tlambertz/rf_gas_meter/example_data/20221119_magnetometer_fine_1h.png

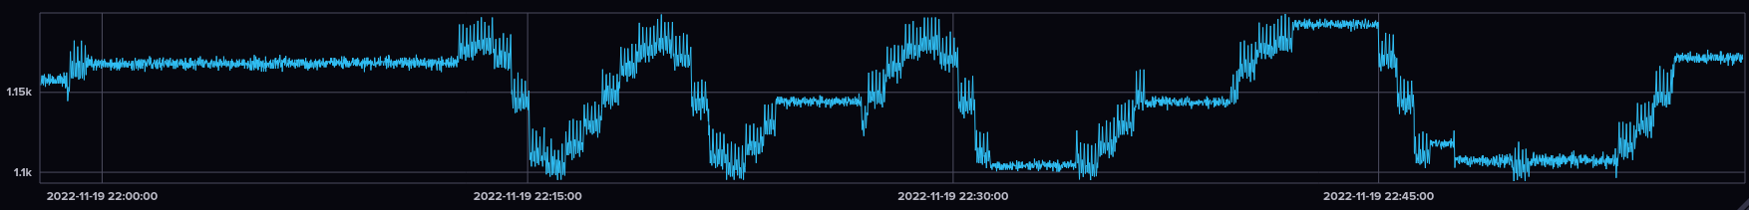
example_data/20221119_magnetometer_fine_1h.png
