tlambertz/rf_gas_meter/example_data/20221119_magnetometer_fine_3h.png

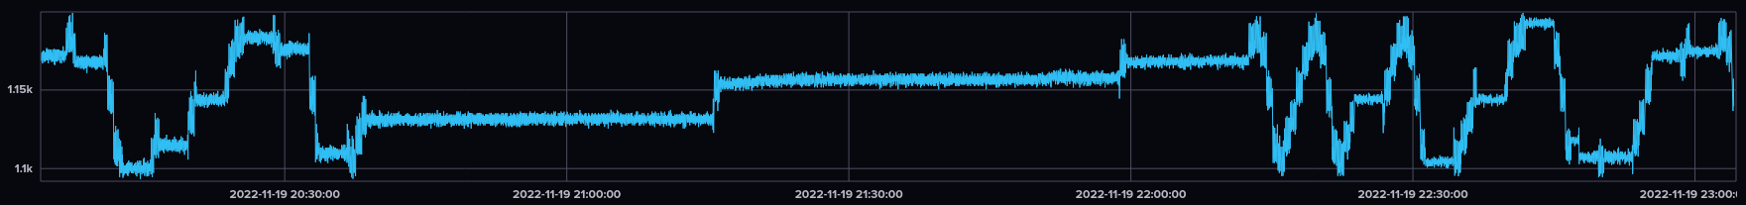
example_data/20221119_magnetometer_fine_3h.png
