tlambertz/rf_gas_meter/example_data/20221120_battery_send_every_1s.png

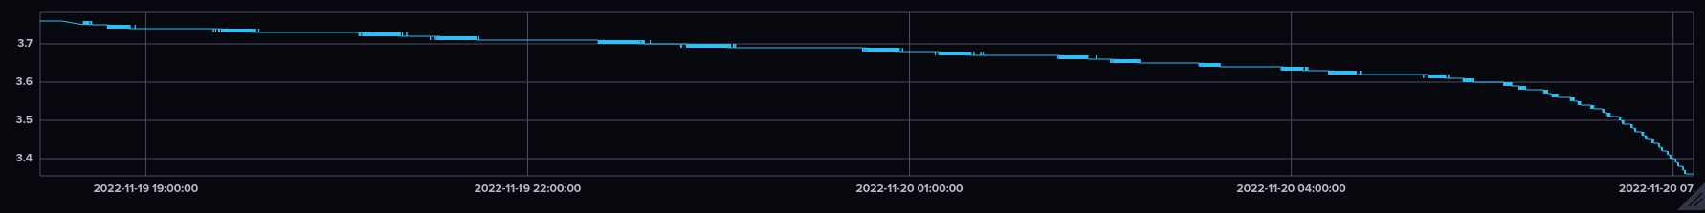
example_data/20221120_battery_send_every_1s.png
