tlambertz/rf_gas_meter/example_data/20221120_mangetometer_over_night.png

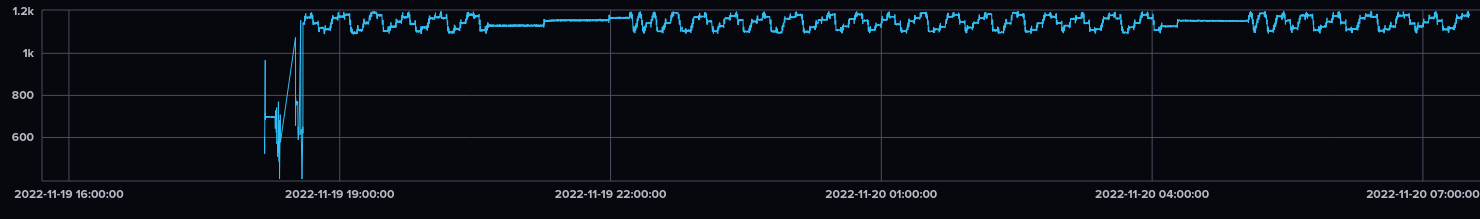
example_data/20221120_mangetometer_over_night.png
