tlambertz/rf_gas_meter/original_radio_node_mini/RadioNodeMini_v1.0.pdf

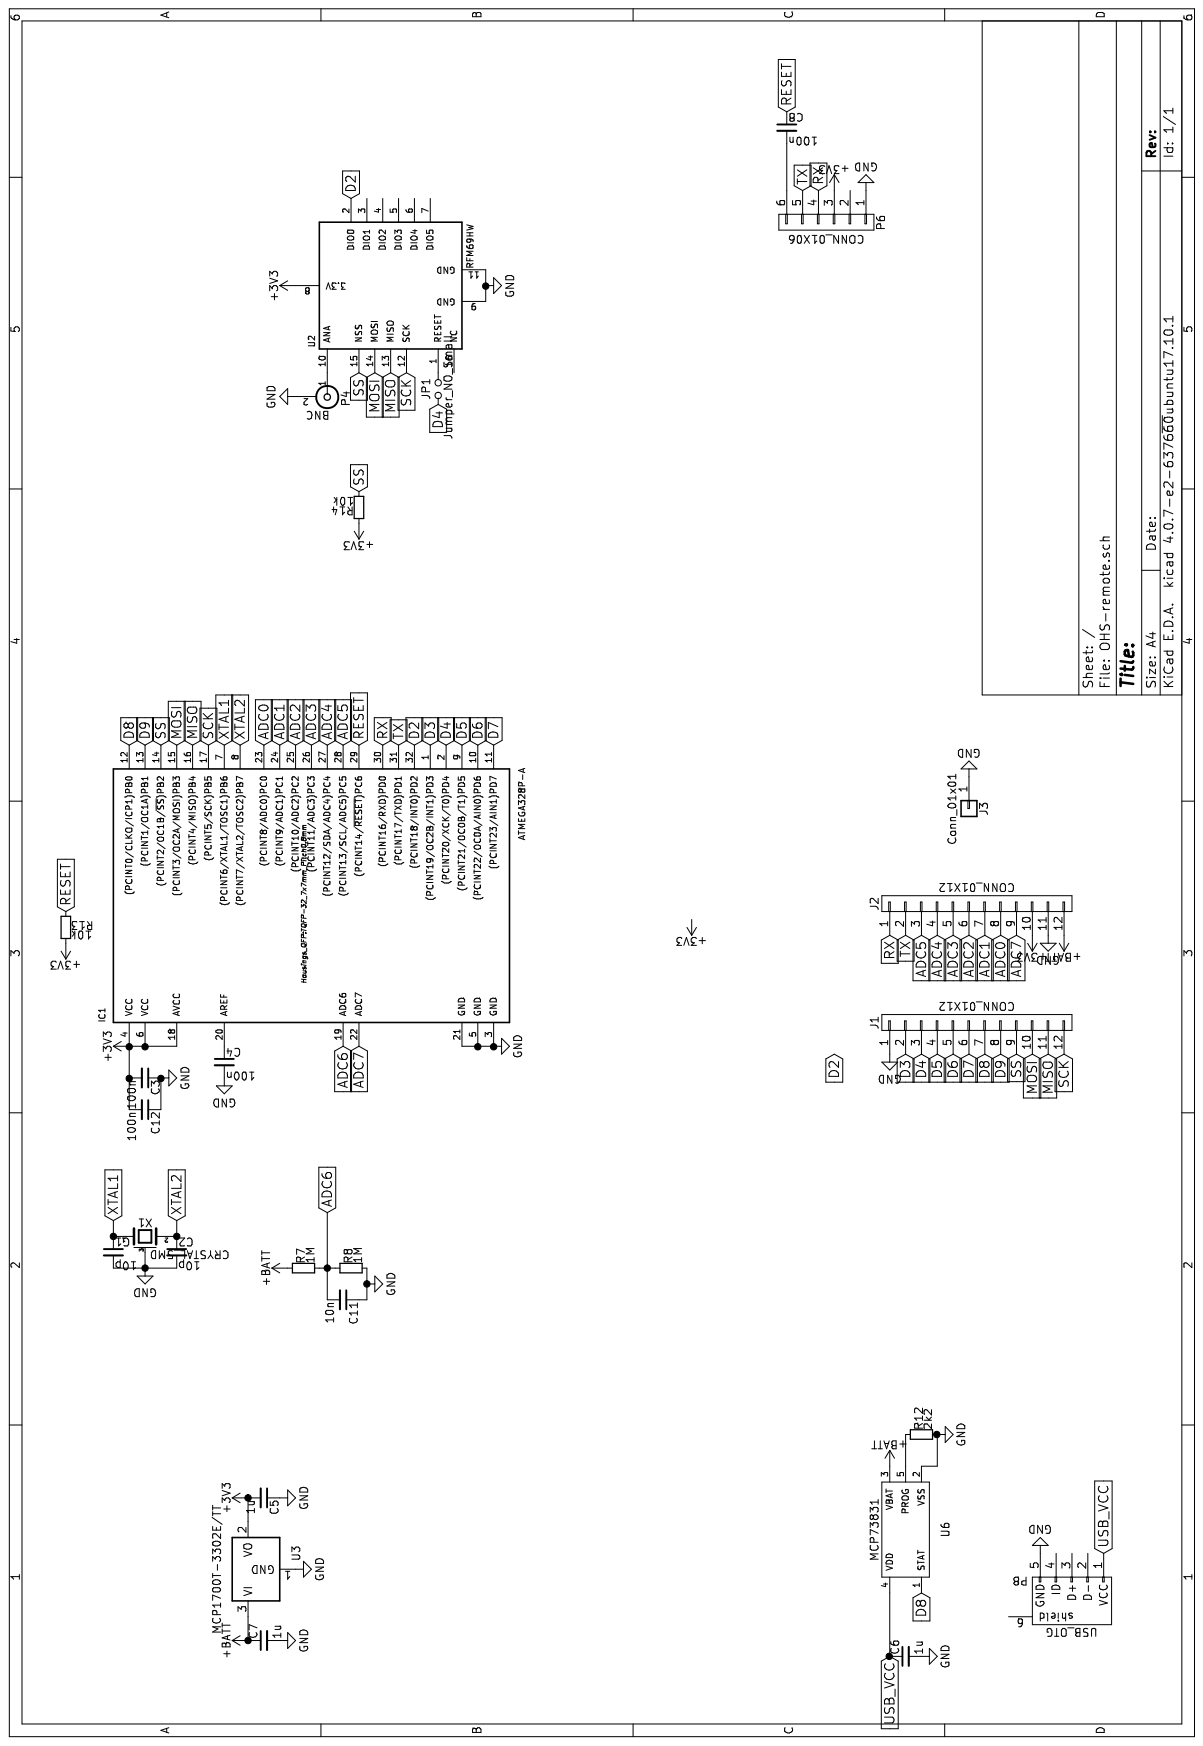
[picture p6: page 1]
