tlambertz/rf_gas_meter/(commit log)

2022-11-12 Add sensor test PIO
2022-11-12 sensors via rf working
2022-11-20 First WIP Solutions and magnetometer measurements
