tlambertz/rf_gas_meter/(notices)

Notices in the files:
node_test_with_sensors/node_test_with_sensors.ino:
Copyright Felix Rusu 2018, http://www.LowPowerLab.com/contact
Public License as published by the Free Software
PiGatewaySimple/PiGatewaySimple.ino:
Copyright Felix Rusu 2016, http://www.LowPowerLab.com/contact
